AsterisCrack/BipedRobotHardware/cad/fusion/README.md

# Fusion 360

`Robot.f3z`, the Fusion 360 archive with the component tree and joints used for the URDF export, is over
GitHub's 100 MB file limit. Download it from the
[latest release](https://github.com/AsterisCrack/BipedRobotHardware/releases/latest) and open it with
File > Open > Open from my computer.

If you don't use Fusion 360, the same design is in [`../step/`](../step/) as STEP.
