AsterisCrack/BipedRobotHardware/docs/build/04_electronics.md

# 04 Electronics

Reference: [`electronics/wiring/`](../../electronics/wiring/) (pinouts, servo IDs) and
[`electronics/power_pcb/`](../../electronics/power_pcb/) (the board).

## 1. Power PCB

Order it or build it (see the [PCB page](../../electronics/power_pcb/README.md#getting-one)), and fit a
blade fuse in each holder.

- **BATTERY** (XT60): the 3S LiPo.
- **SWITCH**: your power switch. It is in series with both outputs, so it turns the whole robot on and off.
- **SERVOS**: servo bus power.
- **JETSON**: a DC barrel lead to the Jetson's power jack.

Before connecting anything, check the polarity of every output with a multimeter.

## 2. Servo bus

Daisy-chain the servos of each leg with their cables and bring both legs back to the body.

## 3. Jetson and servo adapter

Waveshare Bus Servo Adapter (A), wired **straight through**: Jetson pin 8 (TX) to adapter TX, pin 10 (RX)
to adapter RX, pin 6 to GND.

## 4. IMU

BNO055 on I2C bus 7 (pin 3 SDA, pin 5 SCL), address 0x28, in `IMU_tray`. Mount it rotated 180° about the
robot's X (forward) axis, as on the reference build. The runtime corrects for exactly that mounting; see
[wiring](../../electronics/wiring/README.md#imu-mounting) if yours differs.

## Check

Power on with the Jetson disconnected first and measure the SERVOS and JETSON outputs: both should read
the battery voltage (11.1-12.6 V for a 3S LiPo).
