AsterisCrack/BipedRobotHardware/electronics/power_pcb/fabrication/BOM_RobotPCB_2026-03-17.csv

ID | Name | Designator | Footprint | Quantity | Manufacturer Part | Manufacturer | Supplier | Supplier Part | Price
1 | XF-509P | 30A_FUSE2,30A_FUSE1 | CONN-TH_XF-509P | 2 | XF-509P | XFCN(兴飞) | LCSC | C41371872 | 0.306
2 | PJ-002A | WALL_DC | DC-IN-TH_PJ-002A | 1 | PJ-002A | CUI | LCSC | C3096082 | 0.943
3 | KF301-5.0-2P | SERVOS,JETSON,SWITCH | CONN-TH_P5.00_KF301-5.0-2P | 3 | KF301-5.0-2P | KEFA(科发) | LCSC | C474881 | 0.091
4 | XT60 | BATTERY | CONN-TH_XT60 | 1 | XT60-M. | AMASS(艾迈斯) | LCSC | C98733 | 0.27
5 | 1000uF | C1,C2 | CAP-TH_BD8.0-P5.00-D0.6-FD | 2 | JBLE2102M025D140RLM 1000UF 25V | DMBJ(振宝佳) | LCSC | C19270668 | 0.45
6 | 100nF | C3,C4 | C0603 | 2 | GRM188R71E104KA01D | muRata(村田) | LCSC | C77050 | 0.007
7 | SZYY1206G | LED1 | LED1206-R-RD | 1 | SZYY1206G | yongyu(永裕光电) | LCSC | C434439 | 0.019
8 | SB2060FCT_T0_00001 | POWER_OR | ITO-220AB-3_L10.2-W4.5-P2.60-L | 1 | SB2060FCT_T0_00001 | PANJIT(强茂) | LCSC | C268677 | 0.37
9 | 1kΩ | R1 | R0805 | 1 | RCT051KFLF | HKR(香港电阻) | LCSC | C702831
