AsterisCrack/BipedRobotHardware/cad/step/bodies/right_foot.step

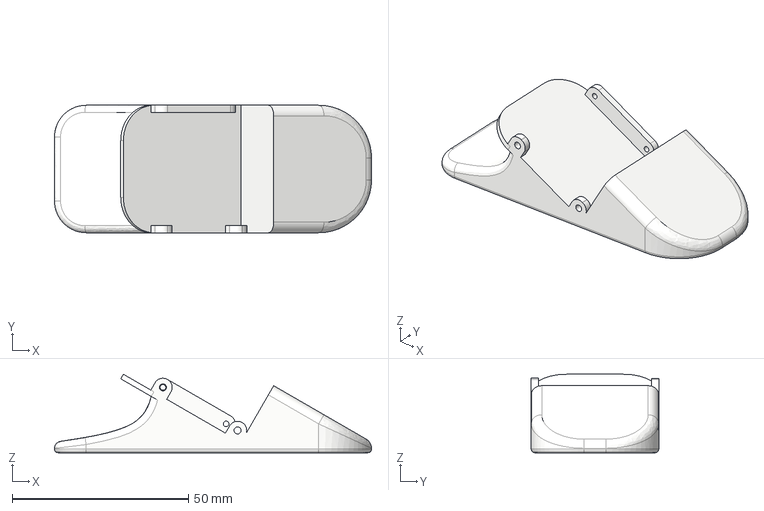
[picture p5: CAD file, 2026-10-30]
cad/step/bodies/right_foot.step
90.0 x 36.2 x 22.3 mm
