AsterisCrack/BipedRobotHardware/print/stl/thigh.stl

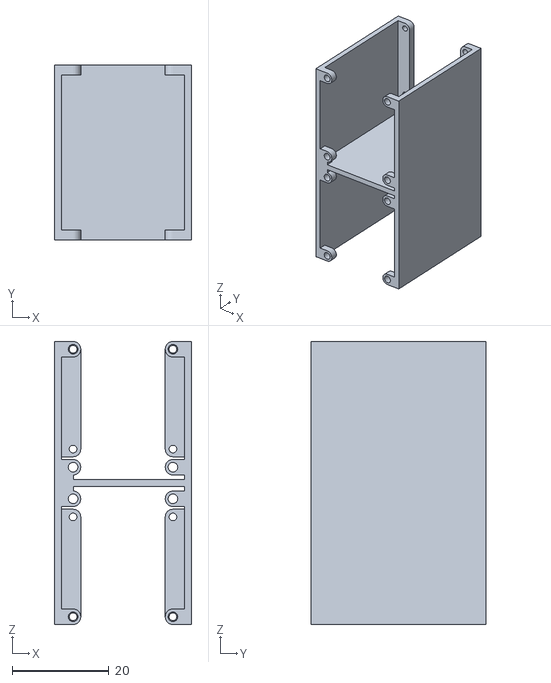
[picture p6: CAD file, 2026-10-30]
print/stl/thigh.stl
28.5 x 36.2 x 58.7
