AsterisCrack/BipedRobotHardware/robot_description/meshes/r_hip_lower_link_1.stl

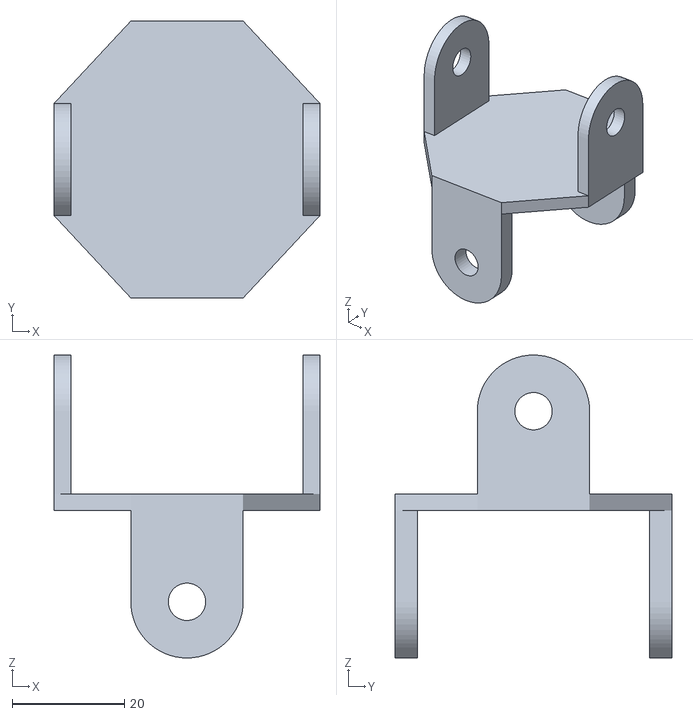
[picture p7: CAD file, 2026-10-30]
robot_description/meshes/r_hip_lower_link_1.stl
47.2 x 49.2 x 53.9
