AsterisCrack/BipedRobotHardware/cad/step/bodies/right_upper_hip.step

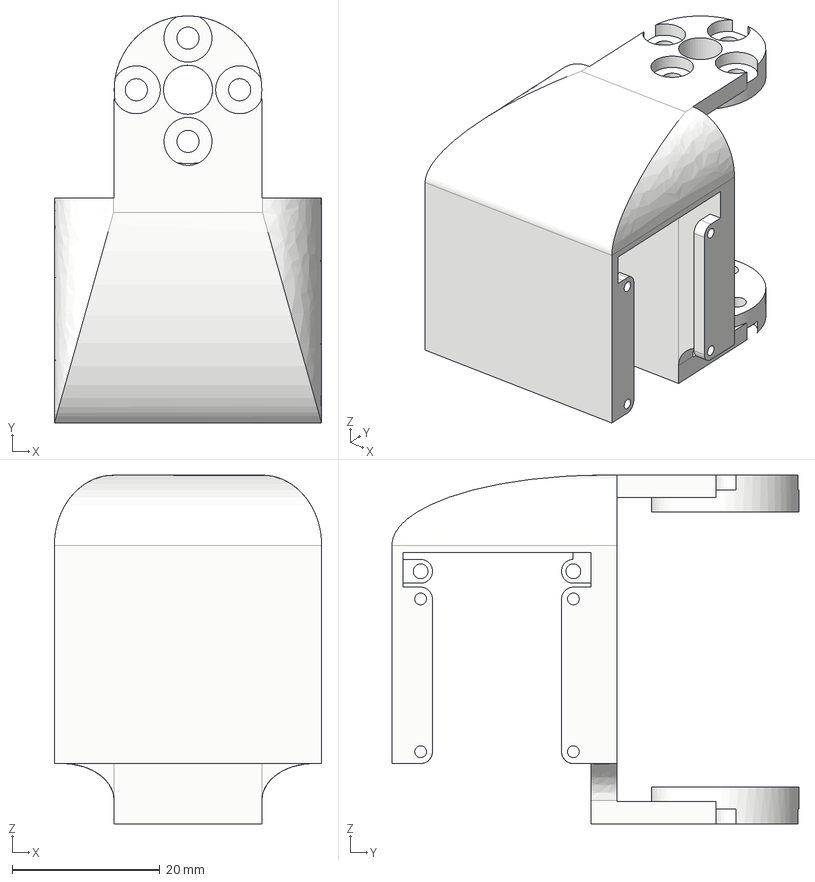
[picture p8: CAD file, 2026-10-30]
cad/step/bodies/right_upper_hip.step
36.2 x 55.2 x 47.3 mm
