AsterisCrack/BipedRobotHardware/robot_description/meshes/base_link.stl

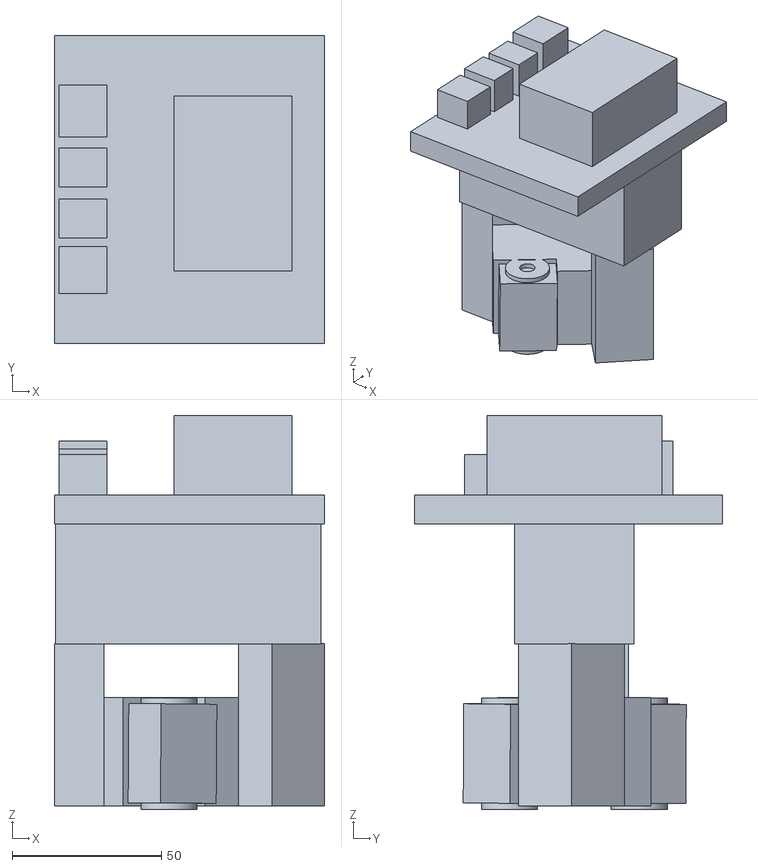
[picture p9: CAD file, 2026-10-30]
robot_description/meshes/base_link.stl
90.5 x 103.0 x 131.8
