AsterisCrack/BipedRobotHardware/cad/step/bodies/body.step

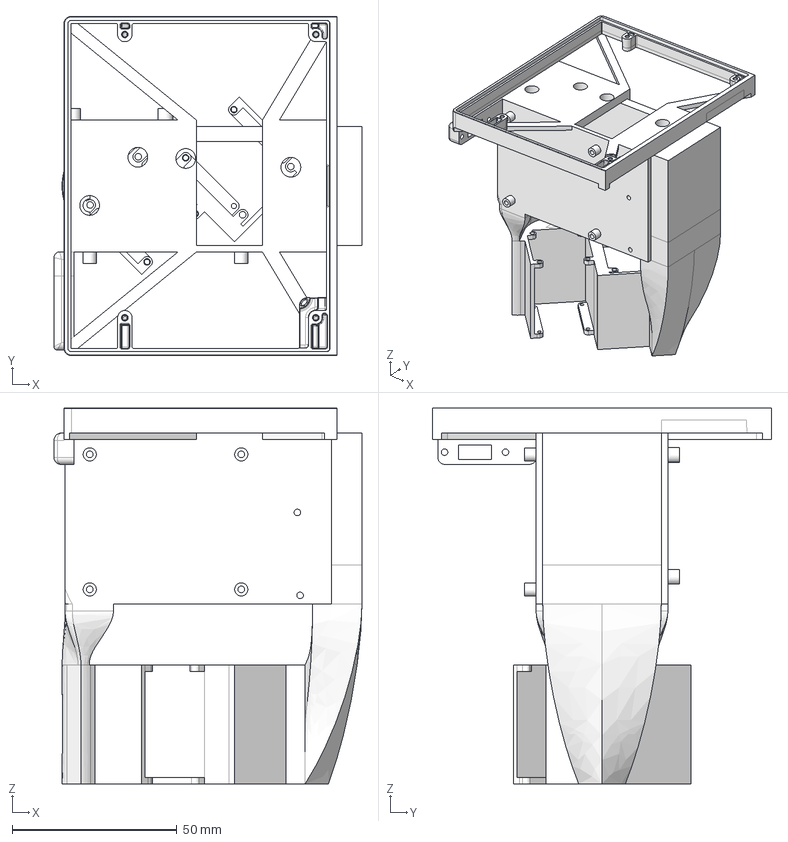
[picture p10: CAD file, 2026-10-30]
cad/step/bodies/body.step
93.5 x 103.0 x 114.2 mm
