AsterisCrack/BipedRobotHardware/robot_description/meshes/l_thigh_link_1.stl

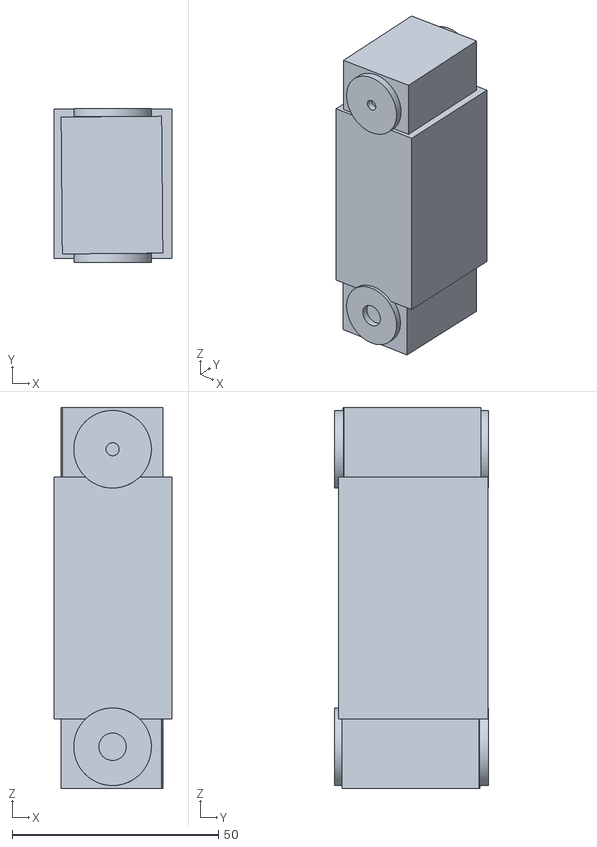
[picture p11: CAD file, 2026-10-30]
robot_description/meshes/l_thigh_link_1.stl
28.5 x 37.2 x 92.3
