AsterisCrack/BipedRobotHardware/cad/step/bodies/calf.step

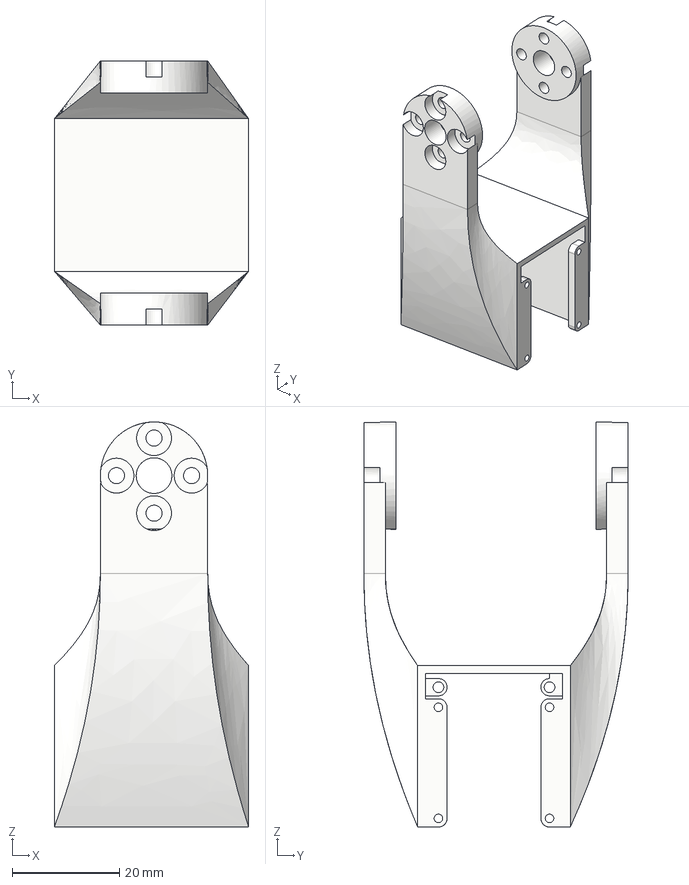
[picture p12: CAD file, 2026-10-30]
cad/step/bodies/calf.step
36.2 x 49.3 x 75.5 mm
