AsterisCrack/BipedRobotHardware/print/stl/ankle_and_hip.stl

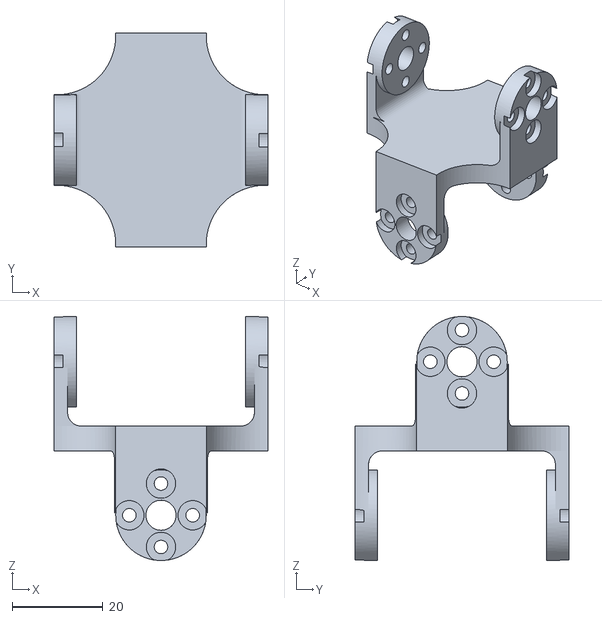
[picture p13: CAD file, 2026-10-30]
print/stl/ankle_and_hip.stl
47.3 x 47.3 x 53.9
