AsterisCrack/BipedRobotHardware/robot_description/meshes/l_hip_upper_link_1.stl

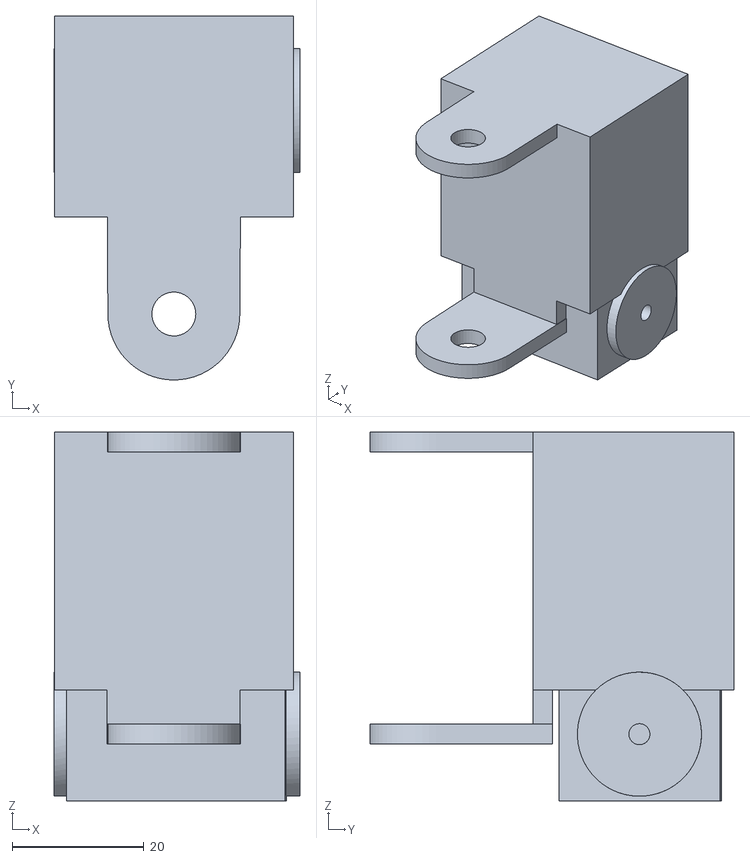
[picture p14: CAD file, 2026-10-30]
robot_description/meshes/l_hip_upper_link_1.stl
37.2 x 55.2 x 55.9
