AsterisCrack/BipedRobotHardware/cad/step/bodies/IMU_tray.step

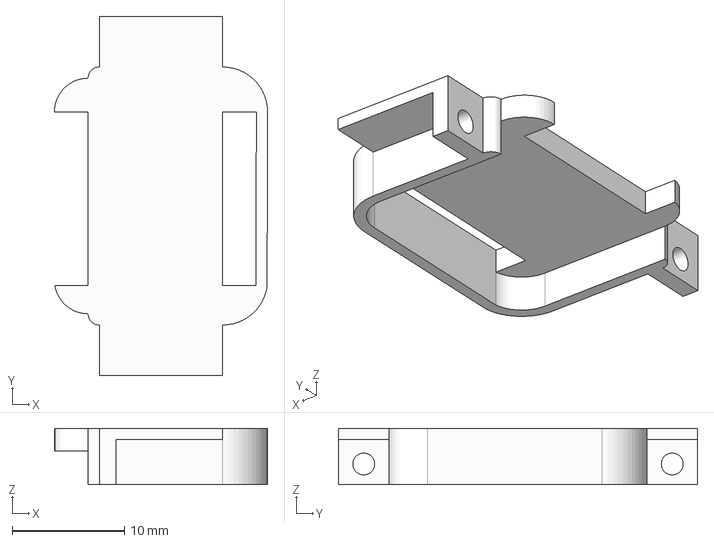
[picture p15: CAD file, 2026-10-30]
cad/step/bodies/IMU_tray.step
19.0 x 32.0 x 5.00 mm
