AsterisCrack/BipedRobotHardware/robot_description/meshes/r_calf_link_1.stl

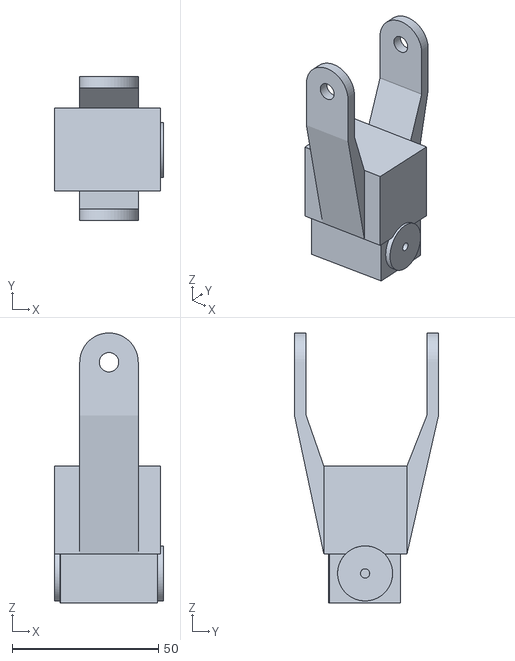
[picture p16: CAD file, 2026-10-30]
robot_description/meshes/r_calf_link_1.stl
37.2 x 49.2 x 92.3
