AsterisCrack/BipedRobotHardware/robot_description/meshes/l_foot_link_1.stl

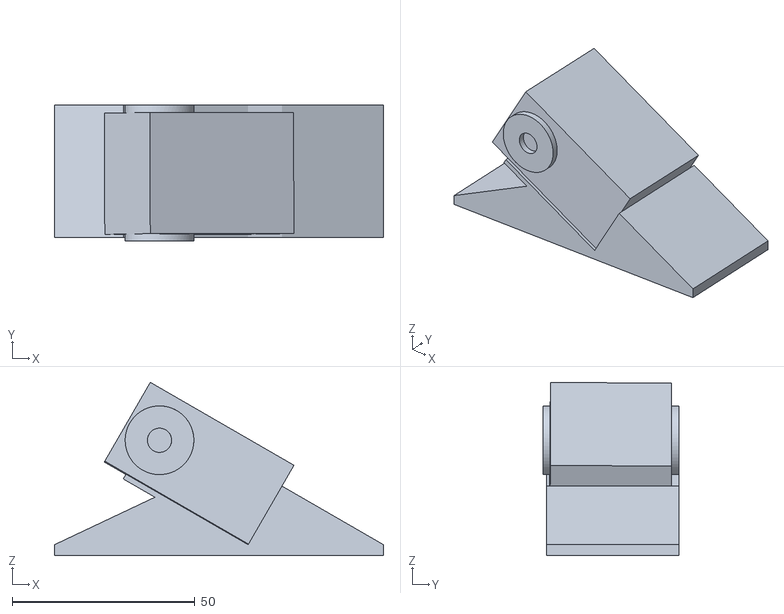
[picture p17: CAD file, 2026-10-30]
robot_description/meshes/l_foot_link_1.stl
90.0 x 37.2 x 47.4
