AsterisCrack/BipedRobotHardware/(list of files, cad)

Other CAD files:
print/stl/right_upper_hip.stl
print/stl/right_foot.stl
print/stl/left_foot.stl
cad/step/bodies/left_foot.step
print/stl/IMU_tray.stl
cad/step/bodies/hip_and_ankle.step
print/stl/left_upper_hip.stl
robot_description/meshes/r_thigh_link_1.stl
cad/step/bodies/left_upper_hip.step
print/stl/calf.stl
robot_description/meshes/r_foot_link_1.stl
cad/step/bodies/thigh.step
robot_description/meshes/l_calf_link_1.stl
robot_description/meshes/r_ankle_link_1.stl
robot_description/meshes/r_hip_upper_link_1.stl
robot_description/meshes/l_hip_lower_link_1.stl
robot_description/meshes/l_ankle_link_1.stl
