AsterisCrack/BipedRobotHardware/docs/build/README.md

# Build guide

From a pile of parts to a robot standing on its own. Work through the steps in order.

| Step | |
|---|---|
| [01 Printing](01_printing.md) | What to print and the one part that needs care |
| [02 Servo setup](02_servo_setup.md) | IDs, ID map, zero and offset calibration. Read this one carefully |
| [03 Legs](03_legs.md) | Assembling each leg, then the hips and torso |
| [04 Electronics](04_electronics.md) | Power PCB, wiring, IMU mounting and orientation |
| [05 Software](05_software.md) | Jetson setup, first power-on, safe standing test |
| [06 Troubleshooting](06_troubleshooting.md) | Common problems and fixes |

Before you start, have everything in [`bom/bom.csv`](../../bom/bom.csv) and the 14 printed parts from
[`bom/printed_parts.csv`](../../bom/printed_parts.csv).

Build photos are coming soon.
