AsterisCrack/BipedRobotHardware/electronics/Schematic_RobotPCB.pdf

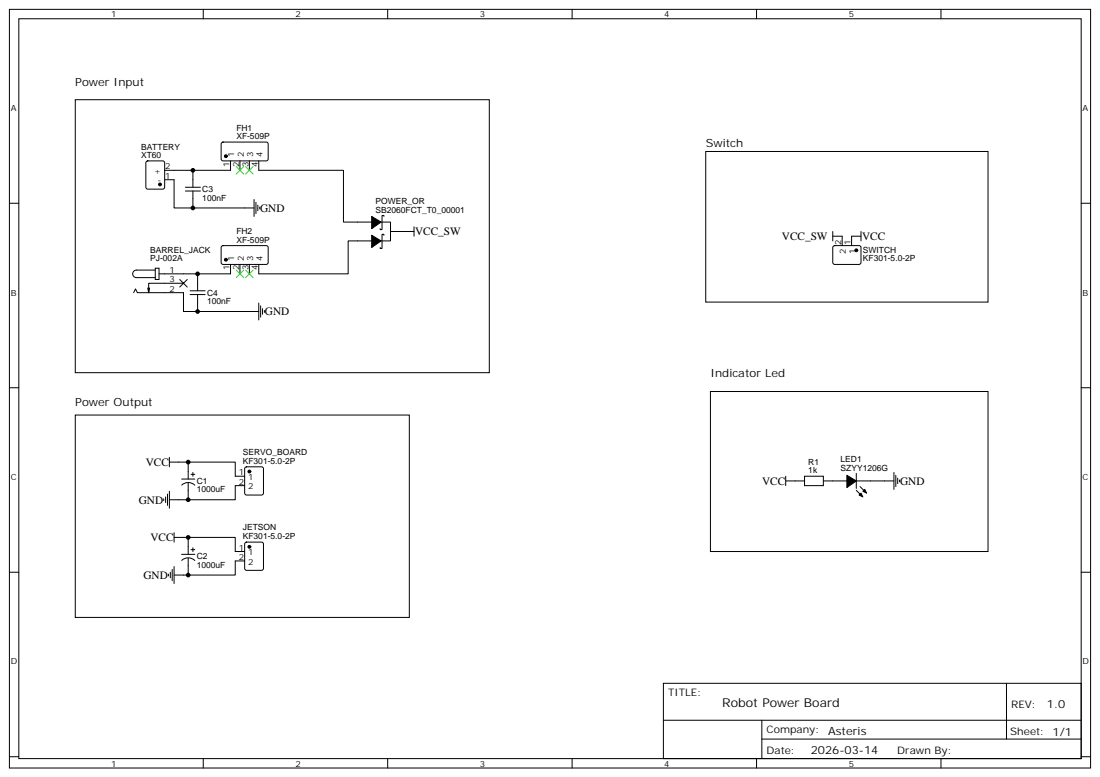
[picture p18: page 1]
