AsterisCrack/BipedRobotHardware/(list of files, drawings)

Other design files:
electronics/power_pcb/source/PCB_PCB_RobotPCB.json
electronics/power_pcb/source/SCH_RobotPCB.json
