AsterisCrack/BipedRobotHardware/(commit log)

2026-10-30 Initial hardware repo: robot description, BOM, PCB, wiring, build guide skeleton
    Robot description moved here from BipedRobot/envs/assets/robotV2/Robot_description
    (the URDF the simulation is trained against, with imu_link), plus a pre-flattened
    robot_flat.urdf. Licensed CERN-OHL-P-2.0; the fusion2urdf template keeps its MIT licence.
    [Robot.urdf, base_link.stl, bom.csv, controller.yaml, l_ankle_link_1.stl, l_calf_link_1.stl, l_foot_link_1.stl, l_hip_lower_link_1.stl]
2026-10-30 Added parts and updated readmes
    [BOM_RobotPCB_2026-03-17.csv, IMU_tray.step, IMU_tray.stl, PCB_PCB_RobotPCB.json, PickAndPlace_PCB_RobotPCB_2026-03-17.csv, SCH_RobotPCB.json, ankle_and_hip.stl, body.step]
